freetronics/EtherDue/(commit log)

2013-04-10 Trace Arduino Due reference schematic into Kicad
    [EtherDue.sch, EtherDue_Connectors.sch, EtherDue_MCU.sch, EtherDue_Mega16U2.sch, EtherDue_Power.sch]
2013-04-10 Remove 74LVC1G125 buffer used for level translation on 16U2 TX pin, replace with resistor divider
    [EtherDue.sch, EtherDue_Connectors.sch, EtherDue_MCU.sch, EtherDue_Mega16U2.sch, EtherDue_Power.sch]
2013-04-11 Add W5100 Ethernet components
    [EtherDue.sch, EtherDue_Connectors.sch, EtherDue_Ethernet.sch, EtherDue_MCU.sch, EtherDue_Mega16U2.sch, EtherDue_Power.sch]
2013-04-11 Update Kicad version from May 2012 to current
    [EtherDue.sch, EtherDue_Connectors.sch, EtherDue_Ethernet.sch, EtherDue_MCU.sch, EtherDue_Mega16U2.sch, EtherDue_Power.sch]
2013-04-11 Final ERC cleanup, export net file
    [EtherDue.sch, EtherDue_Connectors.sch, EtherDue_Ethernet.sch, EtherDue_MCU.sch, EtherDue_Mega16U2.sch, EtherDue_Power.sch]
2013-05-03 Change Ethernet Crystal to a KX-7, load capacitors to match
    [EtherDue_Ethernet.sch]
2013-05-03 Perform component-to-footprint association
2013-05-03 Add symbol library caches for nested schematic sheets
2013-05-03 Edit pass of footprints, cleanup symbols, etc.
    [EtherDue.sch, EtherDue_Connectors.sch, EtherDue_Ethernet.sch, EtherDue_MCU.sch, EtherDue_Mega16U2.sch, EtherDue_Power.sch]
2013-06-05 General clean up, component selection, etc.
    [EtherDue.sch, EtherDue_Connectors.sch, EtherDue_Ethernet.sch, EtherDue_MCU.sch, EtherDue_Mega16U2.sch, EtherDue_Power.sch]
2013-06-05 Footprints checked, components imported to board but most not placed
    [EtherDue.kicad_pcb, EtherDue.sch, EtherDue_Connectors.sch, EtherDue_Ethernet.sch, EtherDue_MCU.sch, EtherDue_Mega16U2.sch, EtherDue_Power.sch]
2013-06-06 Fix LED footprints
    [EtherDue.kicad_pcb, EtherDue.sch, EtherDue_Connectors.sch, EtherDue_Ethernet.sch, EtherDue_MCU.sch, EtherDue_Mega16U2.sch, EtherDue_Power.sch]
2013-06-06 Remove JP301 (breakout for 4 GPIOs from 16u2. Not routed on Due board, definitely won't fit on this board.
    [EtherDue.kicad_pcb, EtherDue.sch, EtherDue_Connectors.sch, EtherDue_Ethernet.sch, EtherDue_MCU.sch, EtherDue_Mega16U2.sch, EtherDue_Power.sch]
2013-06-06 All modules placed roughly on PCB
    [EtherDue.kicad_pcb, EtherDue.sch, EtherDue_Connectors.sch, EtherDue_Ethernet.sch, EtherDue_MCU.sch, EtherDue_Mega16U2.sch, EtherDue_Power.sch]
2013-06-13 Tweak schematics, netlist
    [EtherDue.sch, EtherDue_Connectors.sch, EtherDue_Ethernet.sch, EtherDue_MCU.sch, EtherDue_Mega16U2.sch, EtherDue_Power.sch]
2013-06-20 Pre-autorouter hand routed traces
    [EtherDue.kicad_pcb, EtherDue.sch, EtherDue_Connectors.sch, EtherDue_Ethernet.sch, EtherDue_MCU.sch, EtherDue_Mega16U2.sch, EtherDue_Power.sch]
2013-06-27 Add MicroSD card slot, ready for autorouter
    [EtherDue.kicad_pcb, EtherDue.sch, EtherDue_Connectors.sch, EtherDue_Ethernet.sch, EtherDue_MCU.sch, EtherDue_Mega16U2.sch, EtherDue_Power.sch]
2013-06-27 Move ethernet LEDs to be visible with a PoE board in place
    [EtherDue.kicad_pcb]
2013-06-28 Autorouted, cleaned up, DRC passes
    [EtherDue.kicad_pcb]
2013-06-28 Add front and back ground planes, fatten traces in/out of PTH, general cleanup
    [EtherDue.kicad_pcb]
2013-07-02 Rearrange USB D+/D- traces for better clearances
    [EtherDue.kicad_pcb, EtherDue.sch, EtherDue_Connectors.sch, EtherDue_Ethernet.sch, EtherDue_MCU.sch, EtherDue_Mega16U2.sch, EtherDue_Power.sch]
2013-07-02 Manually length match D+/D- (approx .2mm diff, well within USB HS 3.8mm limit)
    [EtherDue.kicad_pcb]
2013-07-04 Add 24AA025E48 EEPROM w/ unique MAC address
    [EtherDue.kicad_pcb, EtherDue.sch, EtherDue_Connectors.sch, EtherDue_Ethernet.sch, EtherDue_MCU.sch, EtherDue_Mega16U2.sch, EtherDue_Power.sch, EtherDue_peripherals.sch]
2013-07-24 Add SCL1/SDA1 headers (was missing on footprint, mistake updating to R3)
    Finish routing SDA1/SC1 (zero airwires)
    [EtherDue.kicad_pcb, EtherDue.sch, EtherDue_Connectors.sch, EtherDue_Ethernet.sch, EtherDue_MCU.sch, EtherDue_Mega16U2.sch, EtherDue_Power.sch, EtherDue_peripherals.sch]
2013-07-26 Some silkscreening done...
    [EtherDue.kicad_pcb]
2013-07-30 Silkscreen labels, rearrange JTAG connector for easier mechanical clearances
    [EtherDue.kicad_pcb, EtherDue_Connectors.sch]
2013-07-30 Move traces away from edges of board where possible
    [EtherDue.kicad_pcb]
2013-07-30 More silkscreen content, cleanup
    [EtherDue.kicad_pcb]
2013-07-31 More cleanup
    [EtherDue.kicad_pcb]
2013-08-01 More PCB cleanup
    [EtherDue.kicad_pcb]
2013-08-01 Add fiducial marks
    [EtherDue.kicad_pcb]
2013-09-18 Fix ATMega16u2 to run at 16MHz
    [EtherDue_Mega16U2.sch]
2013-09-18 Add labels on comments layer
    [EtherDue.kicad_pcb]
2013-09-18 Fix main SPI header pinout (5 & 6 were backwards)
    [EtherDue.kicad_pcb]
2013-09-19 Update APX811 reset controller for 3.08V threshold
    [EtherDue_Ethernet.sch]
2013-09-19 Enlarge all silkscreen labels where possible
    [EtherDue.kicad_pcb]
2013-09-24 Fix swapped pins 14/17 and 15/18
    [EtherDue.kicad_pcb, EtherDue_Connectors.sch]
2013-09-26 Big power fixes: Fix major problem with VDDOUT/1.8V net, rearrange decoupling capacitors
    [EtherDue.kicad_pcb, EtherDue.sch, EtherDue_Ethernet.sch, EtherDue_MCU.sch, EtherDue_Mega16U2.sch, EtherDue_Power.sch, EtherDue_peripherals.sch]
2013-09-30 Lots of minor cleanup - routing, silkscreen, component positions pre-v0.2 prototype
    [EtherDue.kicad_pcb, EtherDue_Power.sch]
2013-11-20 Fix footprint association on resistor network for RJ45 connection
    [EtherDue.kicad_pcb, EtherDue.sch, EtherDue_Connectors.sch, EtherDue_Ethernet.sch, EtherDue_MCU.sch, EtherDue_Mega16U2.sch, EtherDue_Power.sch, EtherDue_peripherals.sch]
2013-11-25 Substitute larger VIn filter cap (0603 -> 1206) to reduce ripple
    [EtherDue.kicad_pcb, EtherDue.sch, EtherDue_Connectors.sch, EtherDue_Ethernet.sch, EtherDue_MCU.sch, EtherDue_Mega16U2.sch, EtherDue_Power.sch, EtherDue_peripherals.sch]
2013-11-26 Minor rerouting, clear gaps around bolt holes
    [EtherDue.kicad_pcb]
2013-11-26 Fix footprint on D301
    [EtherDue.kicad_pcb]
2013-11-26 Bump version to 0.3
    [EtherDue.kicad_pcb]
2014-01-16 Tweak silkscreen for 1.0 release, bump bulk capacitor value
    [EtherDue.kicad_pcb, EtherDue.sch, EtherDue_Connectors.sch, EtherDue_Ethernet.sch, EtherDue_MCU.sch, EtherDue_Mega16U2.sch, EtherDue_Power.sch, EtherDue_peripherals.sch]
2014-02-03 Add schematic annotations
    [EtherDue.sch, EtherDue_Connectors.sch, EtherDue_Ethernet.sch, EtherDue_MCU.sch, EtherDue_Mega16U2.sch, EtherDue_Power.sch, EtherDue_peripherals.sch]
2014-03-13 Add TX and RX silkscreen labels for the 16u2 LEDs
    [EtherDue.kicad_pcb]
2014-03-13 Add note about DC Input voltages to schematic
    [EtherDue_Power.sch]
2014-04-14 Fix wrong footprint LMV358IDGKR to TSSOP footprint LMV385IPWR
    [EtherDue.kicad_pcb, EtherDue_MCU.sch, EtherDue_Power.sch]
2014-04-14 Add schematic PDF, still a bit wonky from Kicad export to PDF issues
2014-09-25 Update EtherDue from Kicad 2013-07 to 2014-07 (incl. "pretty" footprints, etc.)
    New netlist has been imported into PCB but new "pretty" footprint
    associations HAVE NOT, need to take care if replacing any of these
    from the new libraries as associations may be different.
    [EtherDue.kicad_pcb, EtherDue.sch, EtherDue_Connectors.sch, EtherDue_Ethernet.sch, EtherDue_MCU.sch, EtherDue_Mega16U2.sch, EtherDue_Power.sch, EtherDue_peripherals.sch]
2014-09-25 Add pullup to work around POR bug - http://www.freetronics.com/pages/etherdue-v1-power-on-bug, bump version to v1.2
    [EtherDue.kicad_pcb, EtherDue_MCU.sch]
2014-09-25 General cleanup - silkscreen (some version update weirdness), VOUT routing, bit of other routing
    [EtherDue.kicad_pcb]
2014-09-25 Fix schematic licensing - ED is CC-BY-SA not TAPR OHL
    [EtherDue.sch, EtherDue_Connectors.sch, EtherDue_Ethernet.sch, EtherDue_MCU.sch, EtherDue_Mega16U2.sch, EtherDue_Power.sch, EtherDue_peripherals.sch]
2014-09-25 Update schematic PDF
