freetronics/EtherDue/(notices)

Notices in the files:
EtherDue.kicad_pcb:
Under Creative Commons Attribution ShareAlike License
Licensed by Freetronics Pty Ltd
EtherDue_Power.sch:
(C) 2014 Freetronics Pty Ltd
Licensed under TAPR Open Hardware License
